UjjawalKhatri/CNN_on_Multicore_RV32I/docs/images/chart_efficiency.png

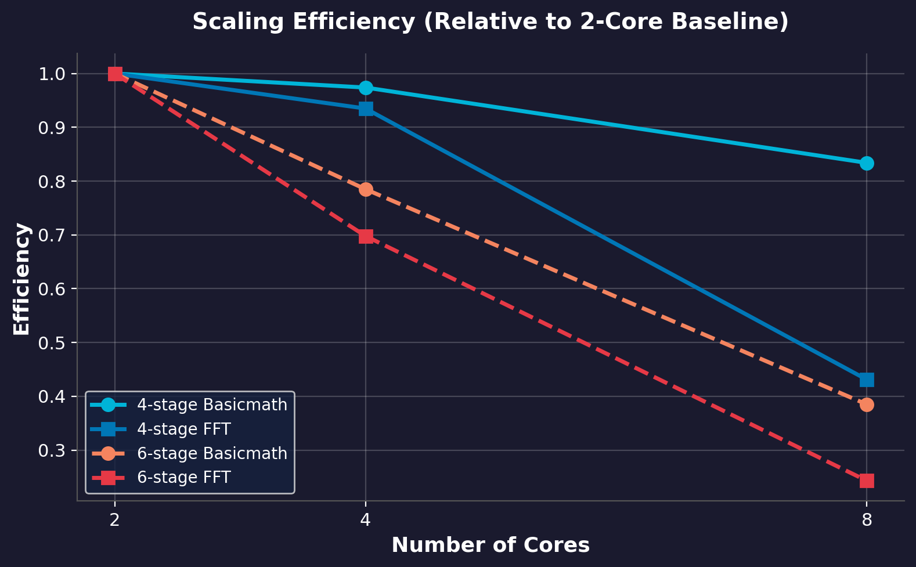
docs/images/chart_efficiency.png
