UjjawalKhatri/CNN_on_Multicore_RV32I/docs/images/chart_power.png

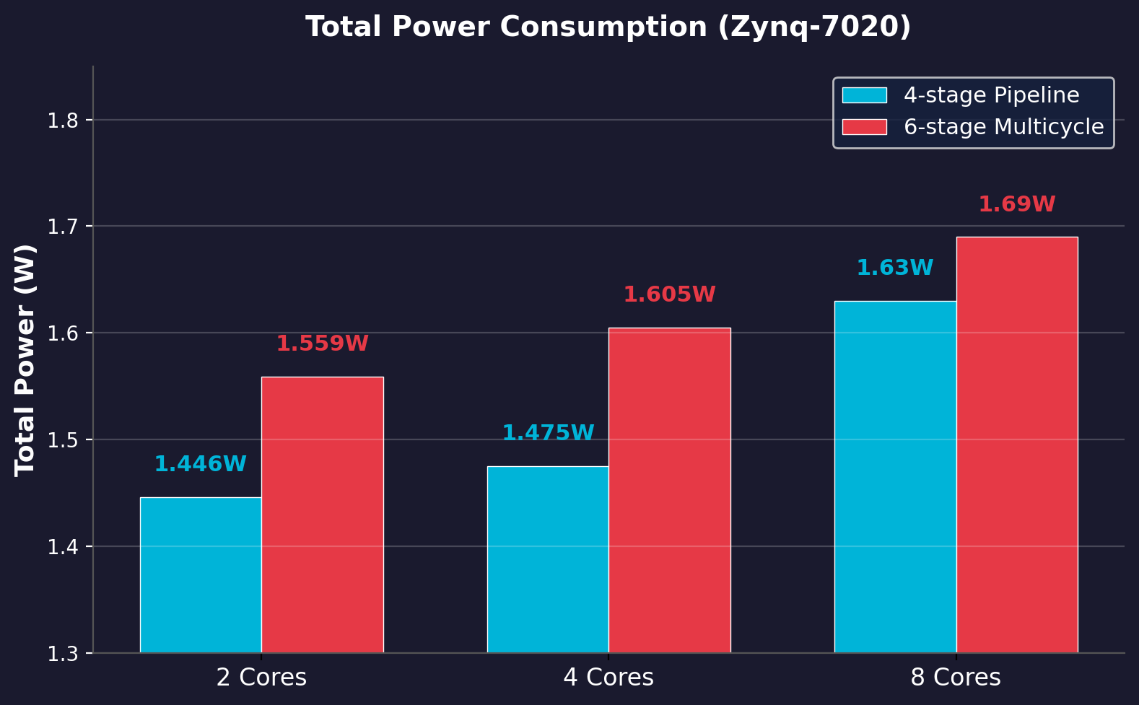
docs/images/chart_power.png
