UjjawalKhatri/CNN_on_Multicore_RV32I/docs/images/chart_speedup.png

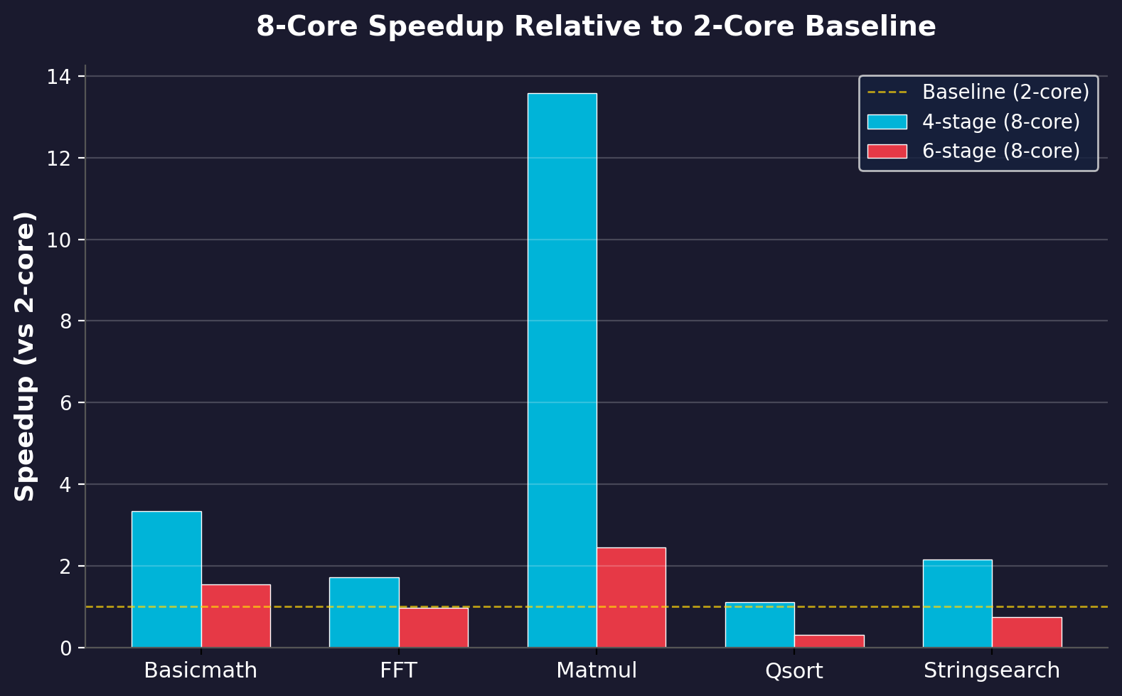
docs/images/chart_speedup.png
