UjjawalKhatri/CNN_on_Multicore_RV32I/host/fruit_cnn_inference/fruit_small_int8_data.h

#ifndef FRUIT_SMALL_INT8_DATA_H
#define FRUIT_SMALL_INT8_DATA_H

#include <stdint.h>

// input
#define FRUIT_INPUT_C 3
#define FRUIT_INPUT_H 32
#define FRUIT_INPUT_W 32
static const float FRUIT_INPUT_SCALE = 0.0039215684f;
static const int32_t FRUIT_INPUT_ZERO = -128;
static const int8_t fruit_input_int8[3072] = {
    -84, -85, -88, -88, -90, -90, -89, -89, -89, -91, -91, -91, -90, -89, -90, -91,
    -91, -90, -56, 69, 84, 81, 82, 81, 83, 83, 82, 80, 83, 82, 83, 82,
    -85, -87, -88, -90, -92, -91, -90, -90, -92, -93, -92, -89, -90, -89, -90, -87,
    -83, -75, -38, 60, 78, 77, 81, 79, 81, 81, 79, 81, 82, 81, 81, 81,
    -87, -88, -89, -90, -92, -91, -91, -91, -93, -92, -92, -81, -82, -79, -71, -61,
    -58, -53, -34, 2, 32, 53, 69, 77, 81, 79, 78, 80, 80, 78, 80, 79,
    -87, -88, -90, -90, -91, -91, -91, -91, -93, -91, -88, -83, -65, -39, -58, -77,
    -82, -81, -67, -47, -22, 30, 62, 72, 76, 78, 79, 79, 78, 78, 79, 79,
    -90, -90, -91, -91, -91, -91, -92, -92, -92, -82, -55, -33, -52, -55, -76, -97,
    -99, -97, -80, -42, -12, 18, 55, 88, 84, 75, 79, 77, 77, 77, 78, 79,
    -90, -90, -91, -92, -91, -92, -92, -92, -80, -62, -47, -27, -2, -58, -82, -97,
    -99, -86, -44, -19, -4, 21, 56, 106, 103, 74, 73, 77, 79, 77, 77, 75,
    -91, -92, -91, -92, -93, -92, -93, -84, -69, -53, -14, 9, 14, -36, -78, -91,
    -86, -40, -16, -24, -19, 8, 40, 87, 84, 51, 57, 65, 76, 74, 76, 71,
    -91, -91, -92, -93, -93, -93, -89, -73, -51, -31, 6, 63, 68, -14, -51, -40,
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
};
static const float fruit_fc2_w_scales[5] = {
    0.0023482721f, 0.0020379145f, 0.0020546308f, 0.0027470840f, 0.0013918317f
};
static const float fruit_fc2_b_float[5] = {
    0.0840567425f, -0.0313137807f, 0.0645967126f, 0.1159873232f, 0.0962489843f
};

#endif
